ClubElecINSSET/WaterMonitor/ESP32/main/PhSensor.h

#ifndef PhSensor_H
#define PhSensor_H

#include "baseSensorClass.h"

class PhSensor : public Sensor
{
public:
    PhSensor(const uint8_t &channel);
    ~PhSensor() override;

    void poll() override;
    void printState() const override;

private:
    // Constant for pH calculation
    static constexpr inline float OFFSET = -5.0f;
};

#endif
