ClubElecINSSET/WaterMonitor/(commit log)

2026-10-11 Rework interface raspberry
2026-10-11 Add lint/format tooling, chart tooltip and tighter offline detection
    - Lint and formatting for the whole repo: ESLint + Prettier (JS/JSX, JSON,
    YAML, Markdown), Ruff (Python), clang-format (ESP32), EditorConfig.
    `npm run lint` / `npm run format` at the root; new "Lint" CI job.
    - Codebase reformatted with these tools (no behaviour change).
    - Dashboard: hover or touch the main chart to see the value and the time of
    a point ("Moyenne" with its time span when the point is an average).
    - Buoy status: "Moyen" after 15 min without a frame, offline after 30 min
    (was 1 h / 3 h). The age is computed with the server clock (`now` in
    /api/measures), so a browser with a wrong clock no longer mat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
